byQ96/LDS/README.md

# LDS
Lightning Detection System is our new project. We are fascinated in physical events and processes. The LDS will be also environment friendly system. We want to buid our devices with the strategy of low current compsumption products.
