byQ96/LDS/sprawozdanie/spr.pdf

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

## 1 Opis projektu

Celem projektu jest konstrukcja niskobud»etowego uniwersalnego odbiornika fal krótkich o zakresie cz¦stotliwo±ci 3 kHz - 300 kHz. Wyªadowanie atmosferyczne generuje fale elektromagnetyczne w bardzo szerokim zakresie cz¦stotliwo±ci. S¡ to impulsy, które mog¡ zosta¢ odebrane ponad 1000 km od wyst¡pienia wyªadowania. Szczegóªowy teoretyczny opis zjawiska mo»na znale¹¢ np. na Wikipedii. Dla cz¦stotliwo±ci ni»szych ni» 100 kHz impulsy wyra¹nie wybijaj¡ si¦ ponad szum atmosferyczny, co pozwala z ªatwo±ci¡ odebra¢ sygnaª. Odbiornik b¦dzie posiada¢ dwa wej±cia na anteny ferrytowe typu H-eld, co pozwoli okre±li¢ przybli»on¡ odlegªo±¢ i kierunek odebranego sygnaªu. Anteny zostan¡ skonstruowane przez wykonawców projektu, ich parametry zostan¡ eksperymentalnie wyznaczone. Po pomy±lnym zainstalowaniu odbiornika nast¦pnym krokiem b¦dzie konstrukcja kilku nast¦pnych, co pozwoli na dokªadniejsze okre±lenie lokalizacji wyst¡pienia wyªadowania za pomoc¡ porówna« czasów odebrania sygnaªu (Time of arrival method). Dane z odbiornika b¦d¡ przesyªane na serwer w celu ich analizy. Projekt zakªada uko«czenie prac nad jednym odbiornikiem i uruchomienie go przed ko«cem roku 2017. Jednym z zaªo»e« jest ªatwe wprowadzanie zmian i dodatkowych moduªów do odbiornika tak, aby jego u»ytkownicy mogli dalej go rozwija¢ oraz mieli mo»liwo±¢ prowadzenia bada«. Planowane jest udost¦pnienie uko«czonej stacji do u»ytku jako projekt wykonany w kole naukowym.

## 2 Zrealizowane zadania i przeprowadzone testy

### 2.1 Schemat prototypu ukªadu ltrów i wzmacniaczy skonstru- owany w programie LTSpice


Rysunek 1: I cz¦±¢ Schematu ukªadu

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

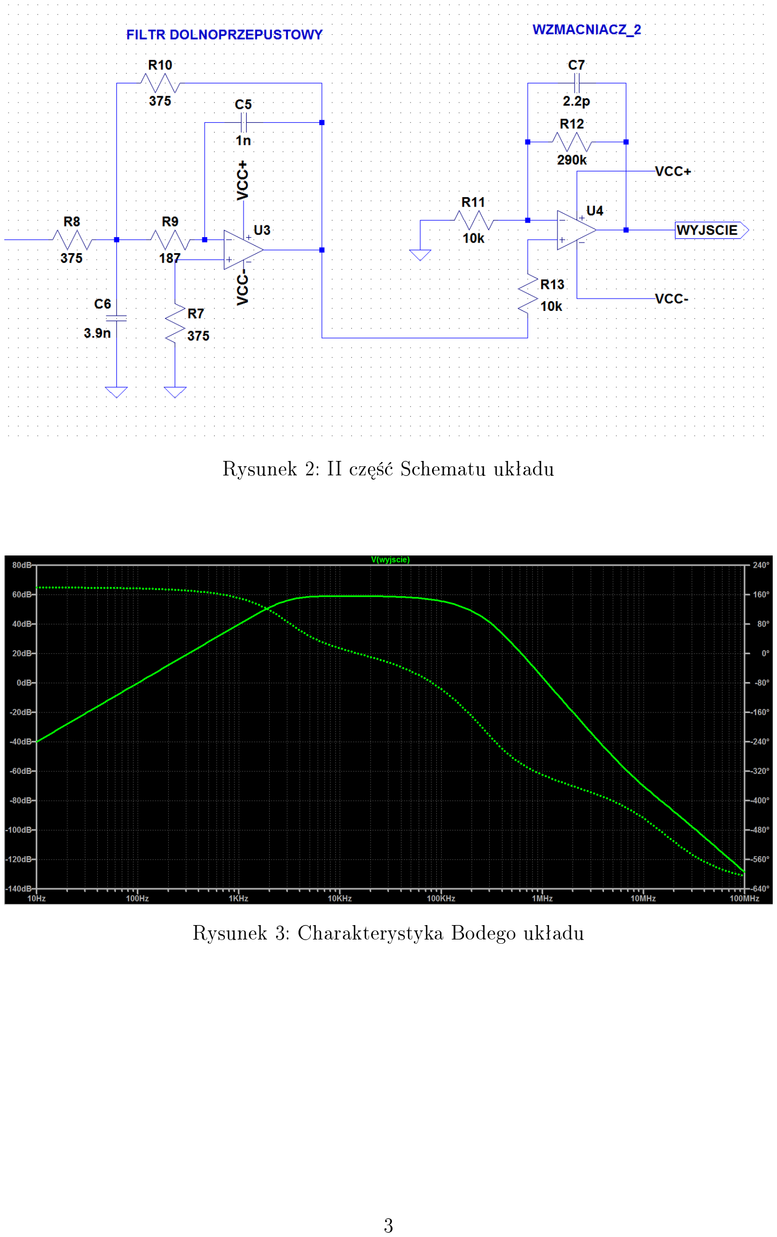
[picture p14: page 3]

### 2.2 Skonstruowanie prototypu ukªadu


Rysunek 4: Prototyp ukªadu

### 2.3 Skonstruowanie anten kierunkowych

zdj¦cie i podpis Anteny kierunkowe uªo»one pod k¡tem prostym podª¡czone do prototypu ukªadu
(Nie wiem kto ma anteny :<)

### 2.4 Testy ukªadu z wyj±ciem podª¡czonym do oscyloskopu

jakie± losowe zdj¦cie np. z lmu i podpis Wykrycie wyªadowania atmosferycznego przez ukªad
(Amadeo tu wrzu¢ klatk¦ z nagrania bo masz w lepszej jako±ci)

### 2.5 Próbkowanie sygnaªu analogowego za pomoc¡ mikrokontro- lera STM32 Nucleo

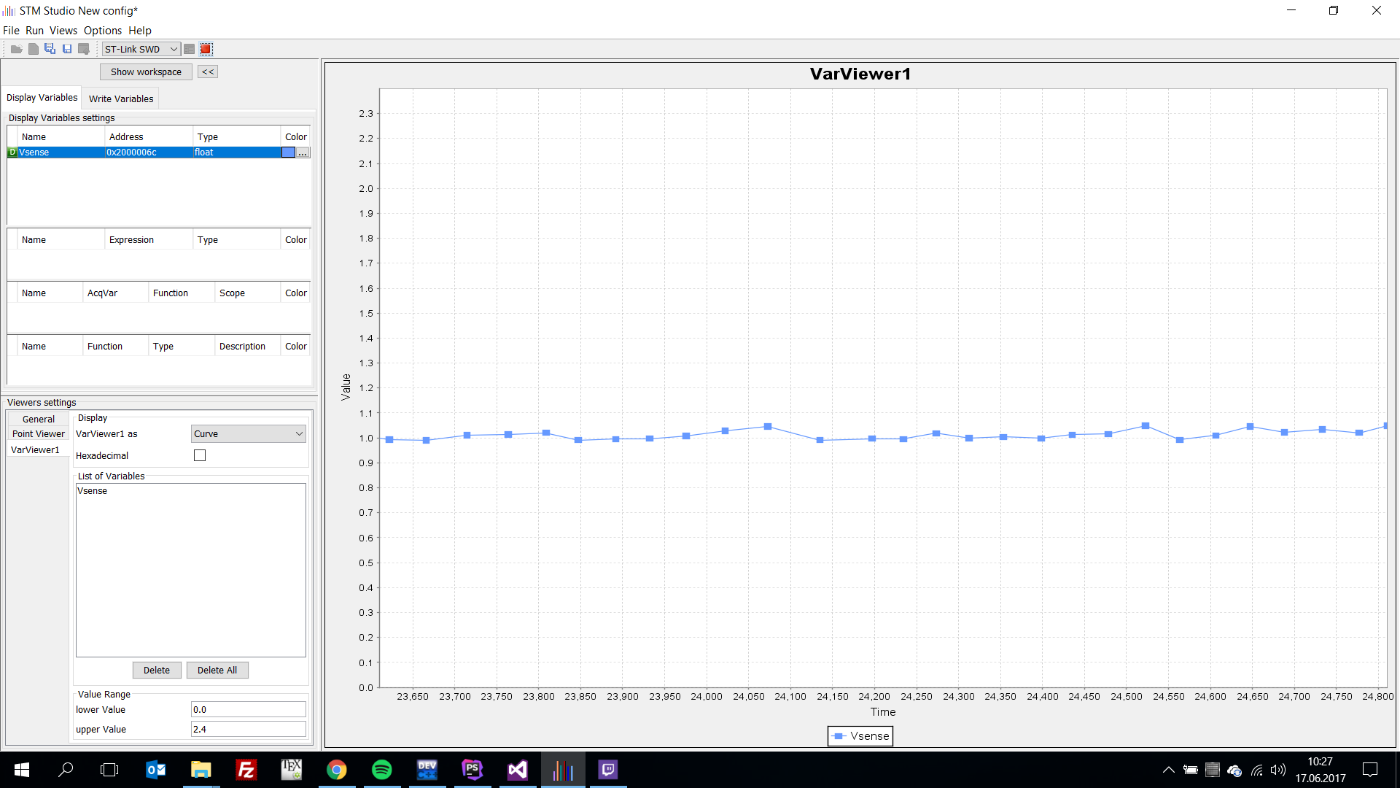
[picture p15: figure]

Rysunek 5: STMStudio - obserwacja sygnaªu na wyj±ciu ukªadu

-zdj¦cie i podpis Schemat poª¡cze« do mikrokontrolera STM32 Nucleo (?) (Amadeo tu wrzu¢, najlepiej pdf na caª¡ stron¦)

## 3 Kontynuacja projektu

Speªnione zostaªy podstawowe zaªo»enia przedstawionego projektu, skonstruowano dziaªaj¡cy odbiornik poprawnie wykrywaj¡cy wyªadowania atmosferyczne i uniezale»-niono go od urz¡dze« laboratoryjnych (oscyloskop) za pomoc¡ przetwornika ADC zawartego w mikrokontrolerze STM32 Nucleo. Nast¦pnym celem jest ulepszenie zestawu ltrów zawartych w ukªadzie i praca nad moduªem GPS, który odpowiedzialny b¦-dzie za zebranie informacji o bardzo dokªadnym czasie wykrycia sygnaªu. W przyszªo-±ci zwie«czeniem projektu b¦dzie konstrukcja kolejnych odbiorników i utworzenie sieci umo»liwiaj¡cej naniesienie dokªadnej lokalizacji wyst¡pienia na map¦.
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
