byQ96/LDS/opis/descripton.pdf

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

## Opis projektu

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

## Plan pracy

Szczegóªowy harmonogram pracy nie jest na dzie« dzisiejszy znany. Terminy poszczególnych zadania b¦d¡ wyznaczane w trakcie realizowania projektu, jako »e ma on by¢ wykonany do ko«ca roku. Pod uwag¦ nale»y bra¢ ewentualne poprawki.

### Wst¦pne przygotowania

z1 | Zgromadzenie podstawowych danych na temat badanego zjawiska.
z2 | Schemat ideowy dziaªania caªego systemu. Okre±lenie parametrów urz¡dze«.
z3 | Szczegóªowy projekt oprogramowania stacji meteorologicznej.
z4 | Schemat elektroniczny i projekt pªytki.
z5 | Projekt konstrukcyjny stacji meteorologicznej.
z6 | Tworzenie konstrukcji.
z7 | Wytrawianie pªytki.
z8 | Monta» elementów elektronicznych na pªytce.
z9 | Oprogramowanie czujnika.
z10 | Monta» konstrukcji stacji.
z11 | Testy oprogramowania, testy urz¡dzenia.
z12 | Utworzenie strony internetowej i akwizycja danych.

## Bud»et

Projekt b¦dzie wymagaª zakupu nast¦puj¡cych cz¦±ci:

- Rdzenie ferrytowe
- Elementy konstrukcyjne do anteny: kabel antenowy, k¡towniki, teowniki, ceowniki
- Nadajnik GPS
- Laminat do wytrawiania
- Akcesoria lutownicze
- Cz¦±ci elektroniczne: wzmacniacze, elementy RLC, przetworniki ADC, mikroprocesory
- Filament do drukarki 3D
- Moduª ª¡czno±ci sieciowej
- Host serwera

Elementy zostan¡ zakupione przez czªonków projektu.

## Przydziaª zada«

Osoba | Zadania
Mateusz Otto | z5, z6, z10
Michaª Wieczorek | z4, z5, z6, z10
Rafaª Ró»ycki | z4, z7, z8
Amadeusz Wach | z9, z12
Wspólnie | z1, z2, z3, z11

Tabela 1: Podziaª zada«

### Zespóª projektowy

Michaª Wieczorek - lider, odpowiedzialny za:

- Projekt konstrukcyjny stacji meteorologicznej
- Tworzenie konstrukcji
- Monta» konstrukcji stacji
- Schemat elektroniczny i projekt pªytki

Mateusz Otto odpowiedzialny za:

- Projekt konstrukcyjny stacji meteorologicznej
- Tworzenie konstrukcji
- Monta» konstrukcji stacji

Rafaª Ró»ycki odpowiedzialny za:

- Schemat elektroniczny i projekt pªytki
- Wytrawianie pªytki
- Monta» elementów elektronicznych na pªytce

Amadeusz Wach odpowiedzialny za:

- Oprogramowanie czujnika
- Utworzenie strony internetowej i akwizycja danych

## Zarz¡dzanie projektem

Liderem projektu b¦dzie Michaª Wieczorek - pomysªodawca i inicjator projektu. Czªonkowie projektu s¡ zobowi¡zani do realizowania wyznaczonych im zada« oraz systematycznej pracy. Jakiekolwiek napotkane problemy b¦d¡ rozwi¡zywane wspólnie. Kontrola projektu b¦dzie si¦ odbywaªa przez githuba.

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

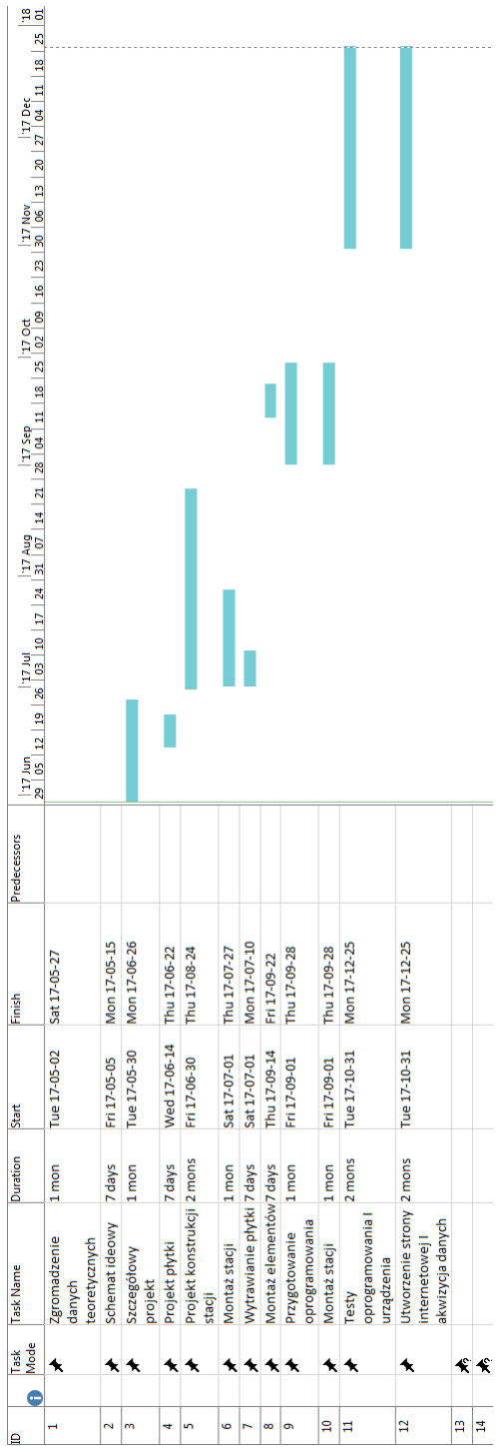
[picture p16: figure]
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
