byQ96/LDS/opis/zad1.png

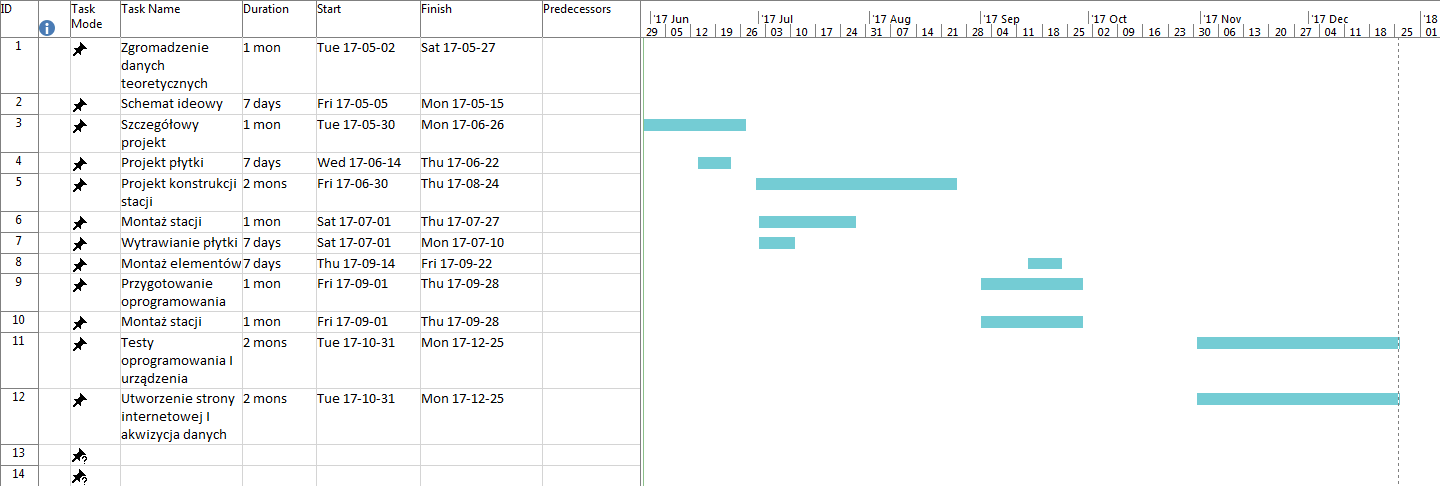
opis/zad1.png
