byQ96/LDS/sprawozdanie/v2/figures/19359076_1351595771560368_536672732_o.jpg

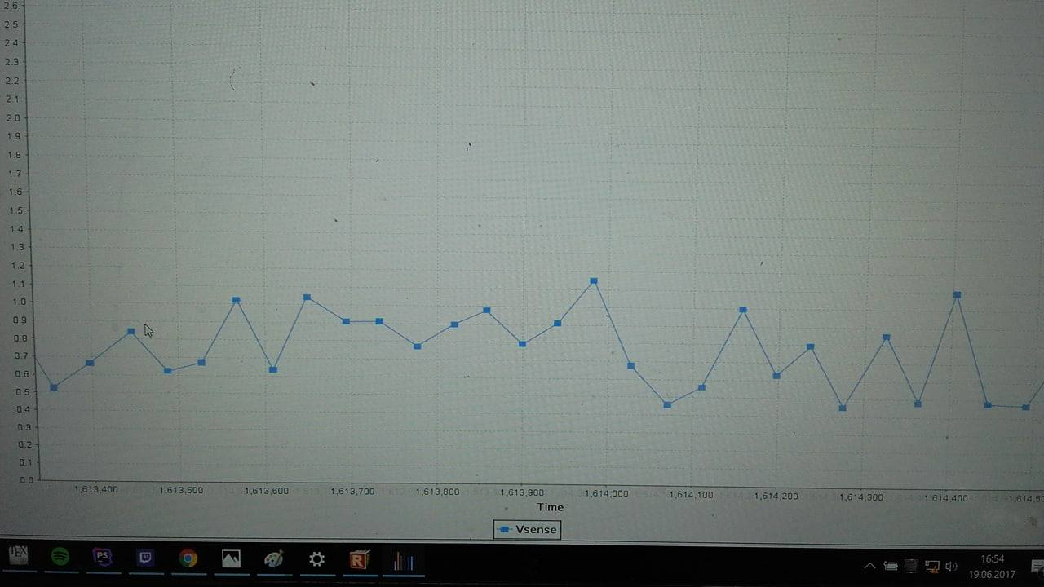
sprawozdanie/v2/figures/19359076_1351595771560368_536672732_o.jpg
