byQ96/LDS/sprawozdanie/v2/figures/19403394_1351595791560366_622665805_o.jpg

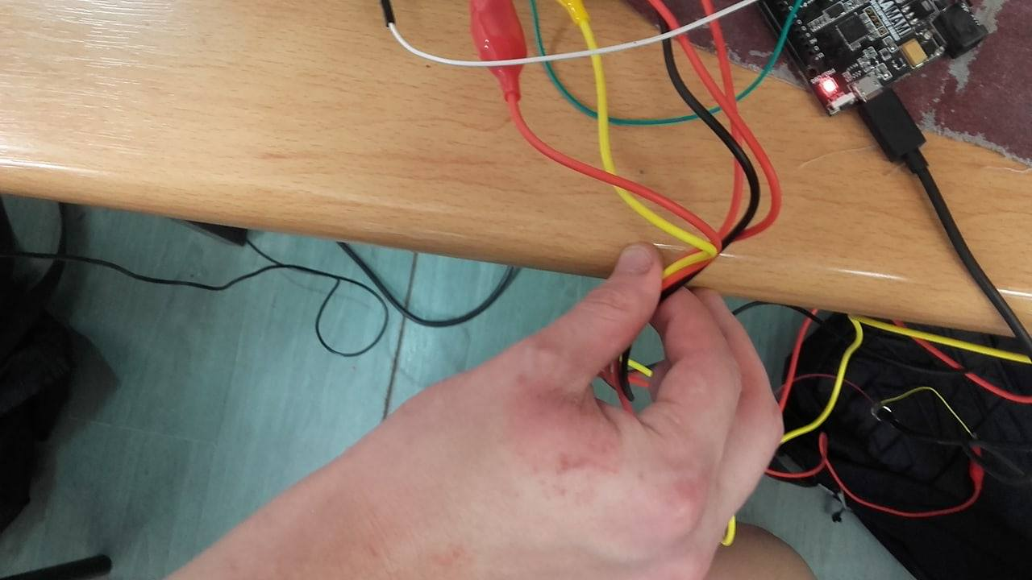
sprawozdanie/v2/figures/19403394_1351595791560366_622665805_o.jpg
