byQ96/LDS/sprawozdanie/v2/figures/antplstm.jpg

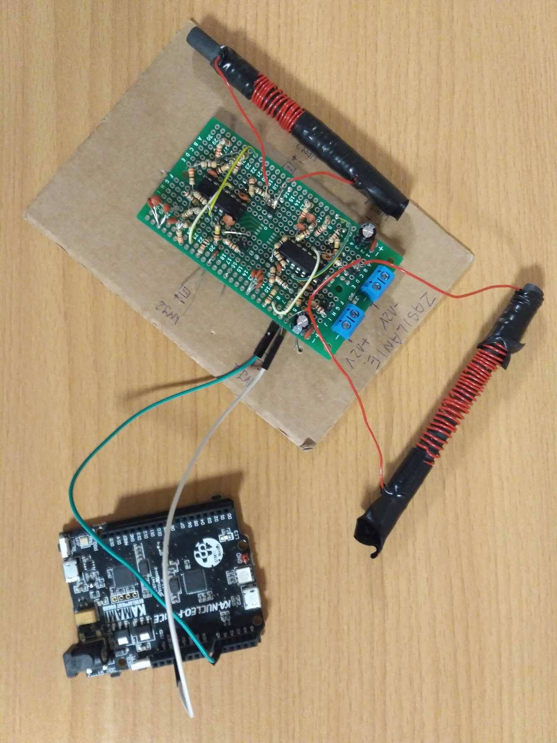
sprawozdanie/v2/figures/antplstm.jpg
