byQ96/LDS/sprawozdanie/v2/figures/antplstm.png

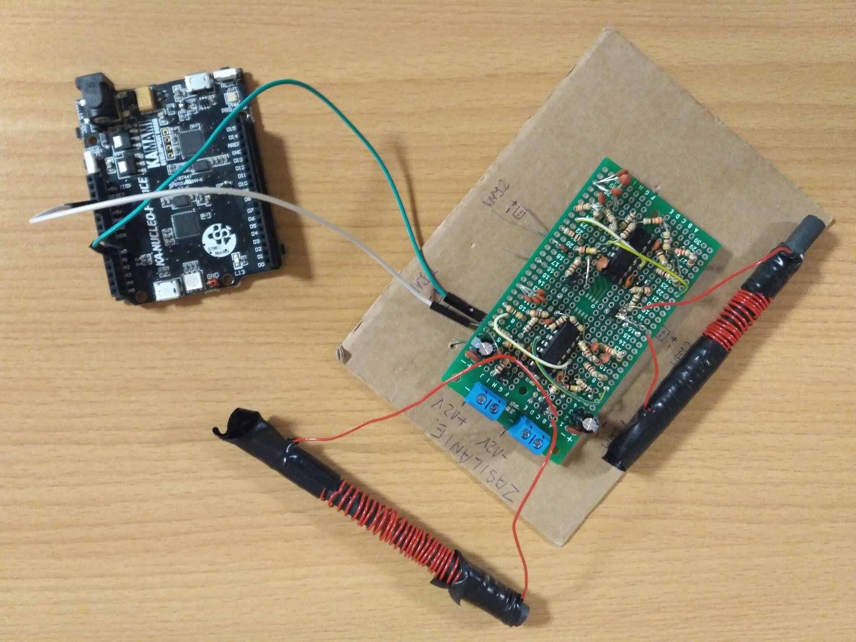
sprawozdanie/v2/figures/antplstm.png
