byQ96/LDS/sprawozdanie/v2/figures/plytka.jpg

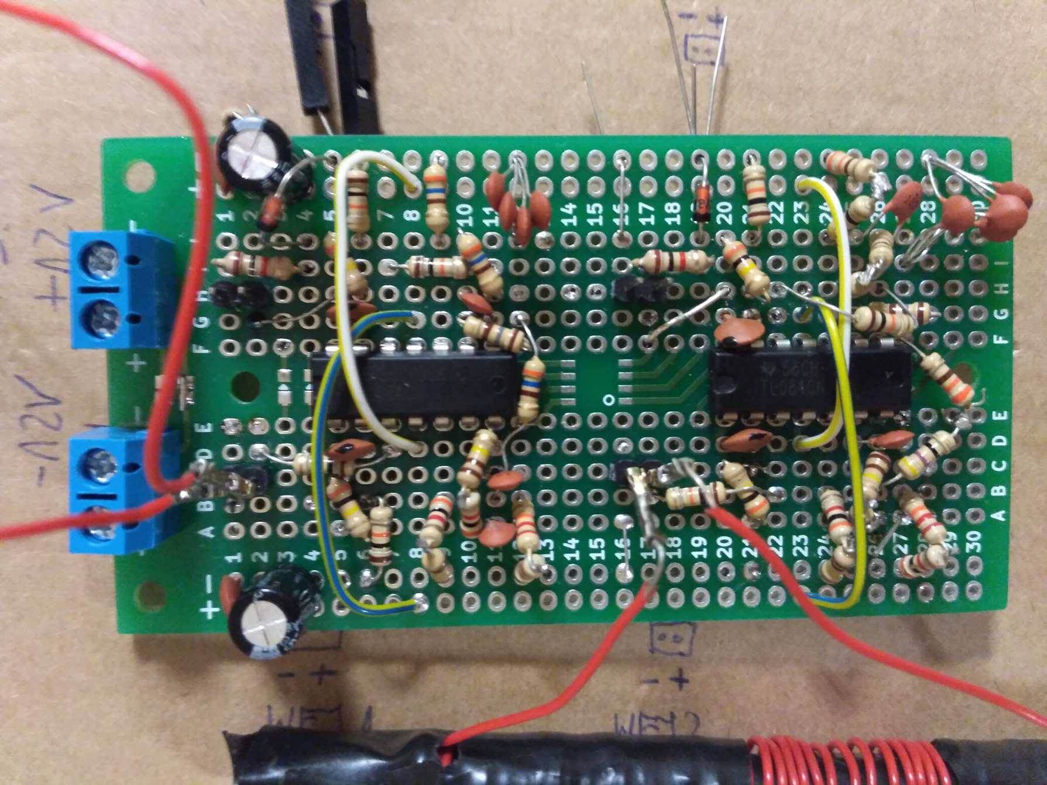
sprawozdanie/v2/figures/plytka.jpg
