byQ96/LDS/sprawozdanie/v2/figures/ukladantena.jpg

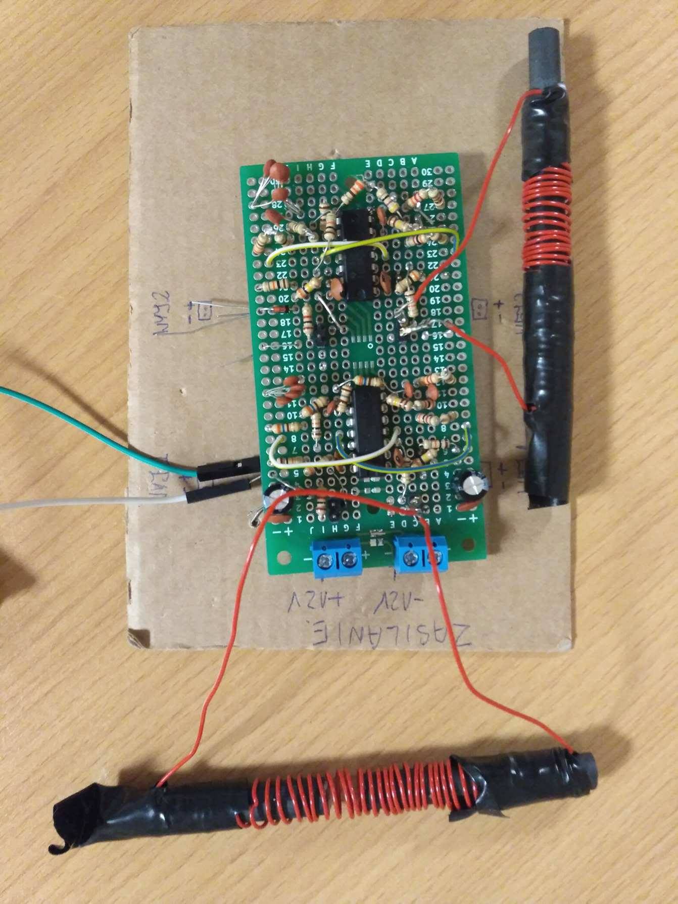
sprawozdanie/v2/figures/ukladantena.jpg
