byQ96/LDS/sprawozdanie/v2/figures/schematcal.pdf

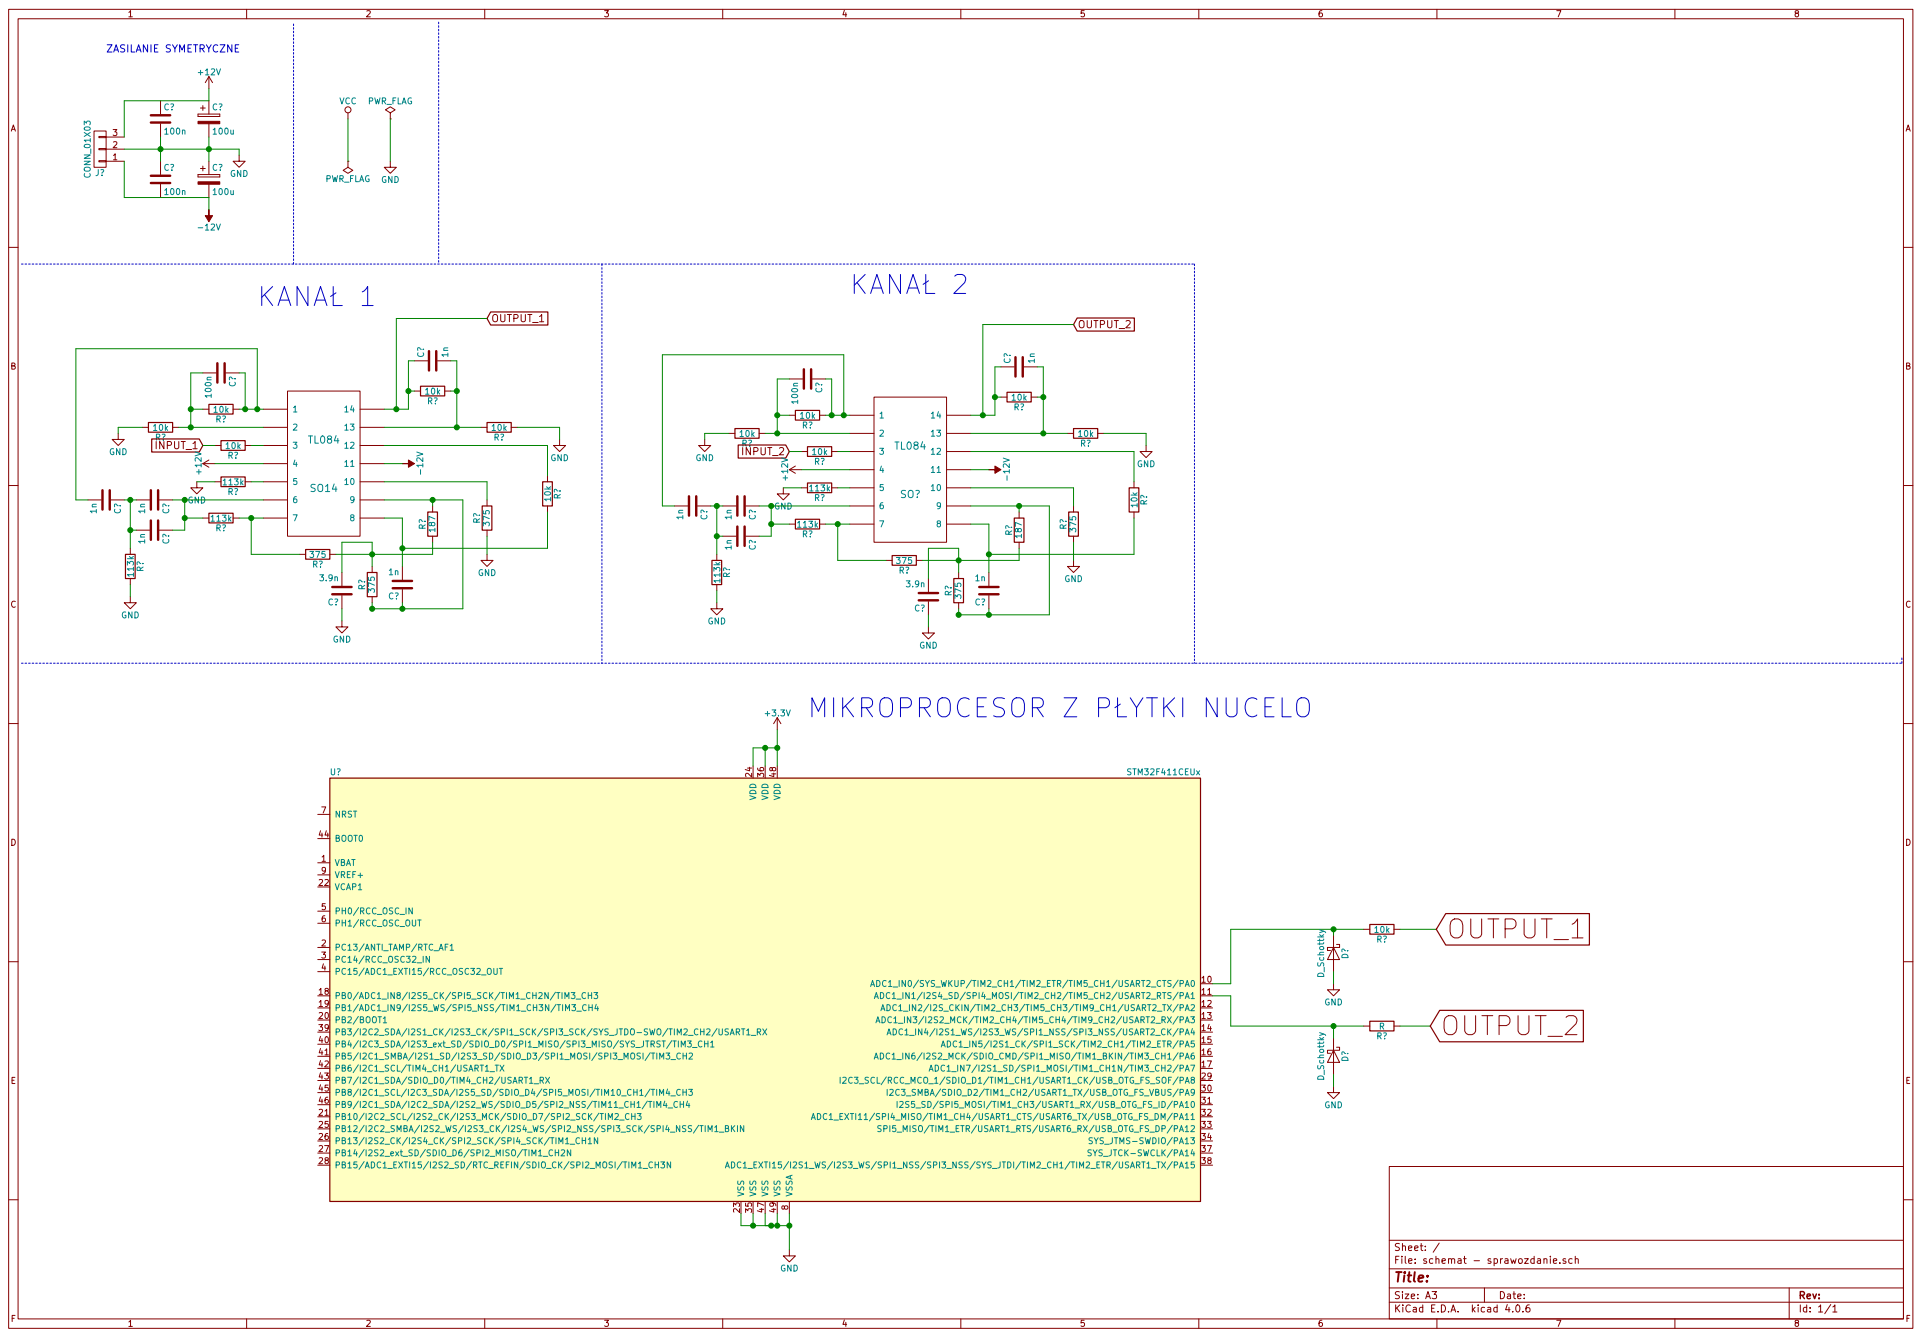
[picture p24: page 1]

Id: 1/1 Title: File: schemat - sprawozdanie.sch Sheet: /
