byQ96/LDS/schemat/wyladowania.asc

C1: cap; 1n
C2: cap; 2.2p
C3: cap; 1n
C4: cap; 1n
C5: cap; 1n
C6: cap; 3.9n
C7: cap; 2.2p
R1: res; 113k
R2: res; 25k
R3: res; 10k
R4: res; 290k
R5: res; 10k
R6: res; 113k
R7: res; 375
R8: res; 375
R9: res; 187
R10: res; 375
R11: res; 10k
R12: res; 290k
R13: res; 10k
U1: UniversalOpamp2
U2: UniversalOpamp2
U3: UniversalOpamp2
U4: UniversalOpamp2
V1: voltage; +12
V2: voltage; -12
V4: voltage; ""; AC 1
Named nets: 0, VCC+, VCC-, WYJSCIE, WEJSCIE
WZMACNIACZ_1
FILTR GÓRNOPRZEPUSTOWY
FILTR DOLNOPRZEPUSTOWY
.ac oct 100 10 100000000
WZMACNIACZ_2
ZASILANIE
