byQ96/LDS/program/UART/UART.ioc

Mcu.UserName=STM32F411RETx
PA0-WKUP.Signal=ADCx_IN0
PA2.Signal=USART2_TX
PA3.Signal=USART2_RX
