byQ96/LDS/(commit log)

2017-10-07 Dodano DMA na jeden kanał
    [BURZA.cfg]
2017-10-08 podział białe i czarne nucleo
    [BURZA.cfg]
2017-10-08 Działający jeden kanał DMA
    [BURZA.cfg]
2017-11-06 Działający bufor DMA
    Bufor przesyłający dane (0-255) przez UART
