byQ96/LDS/(notices)

Notices in the files:
program/UART/Src/main.c:
(C) COPYRIGHT STMicroelectronics *****END OF FILE
